McPcholkin/DIY_Soldering_Station/README.md

testing  and developing DIY soldering station
