McPcholkin/DIY_Soldering_Station/DIY_Soldering_Station-eagle/ProMini-connection.sch

## EAGLE design DIY_Soldering_Station-eagle/ProMini-connection.sch (2017-05-05)

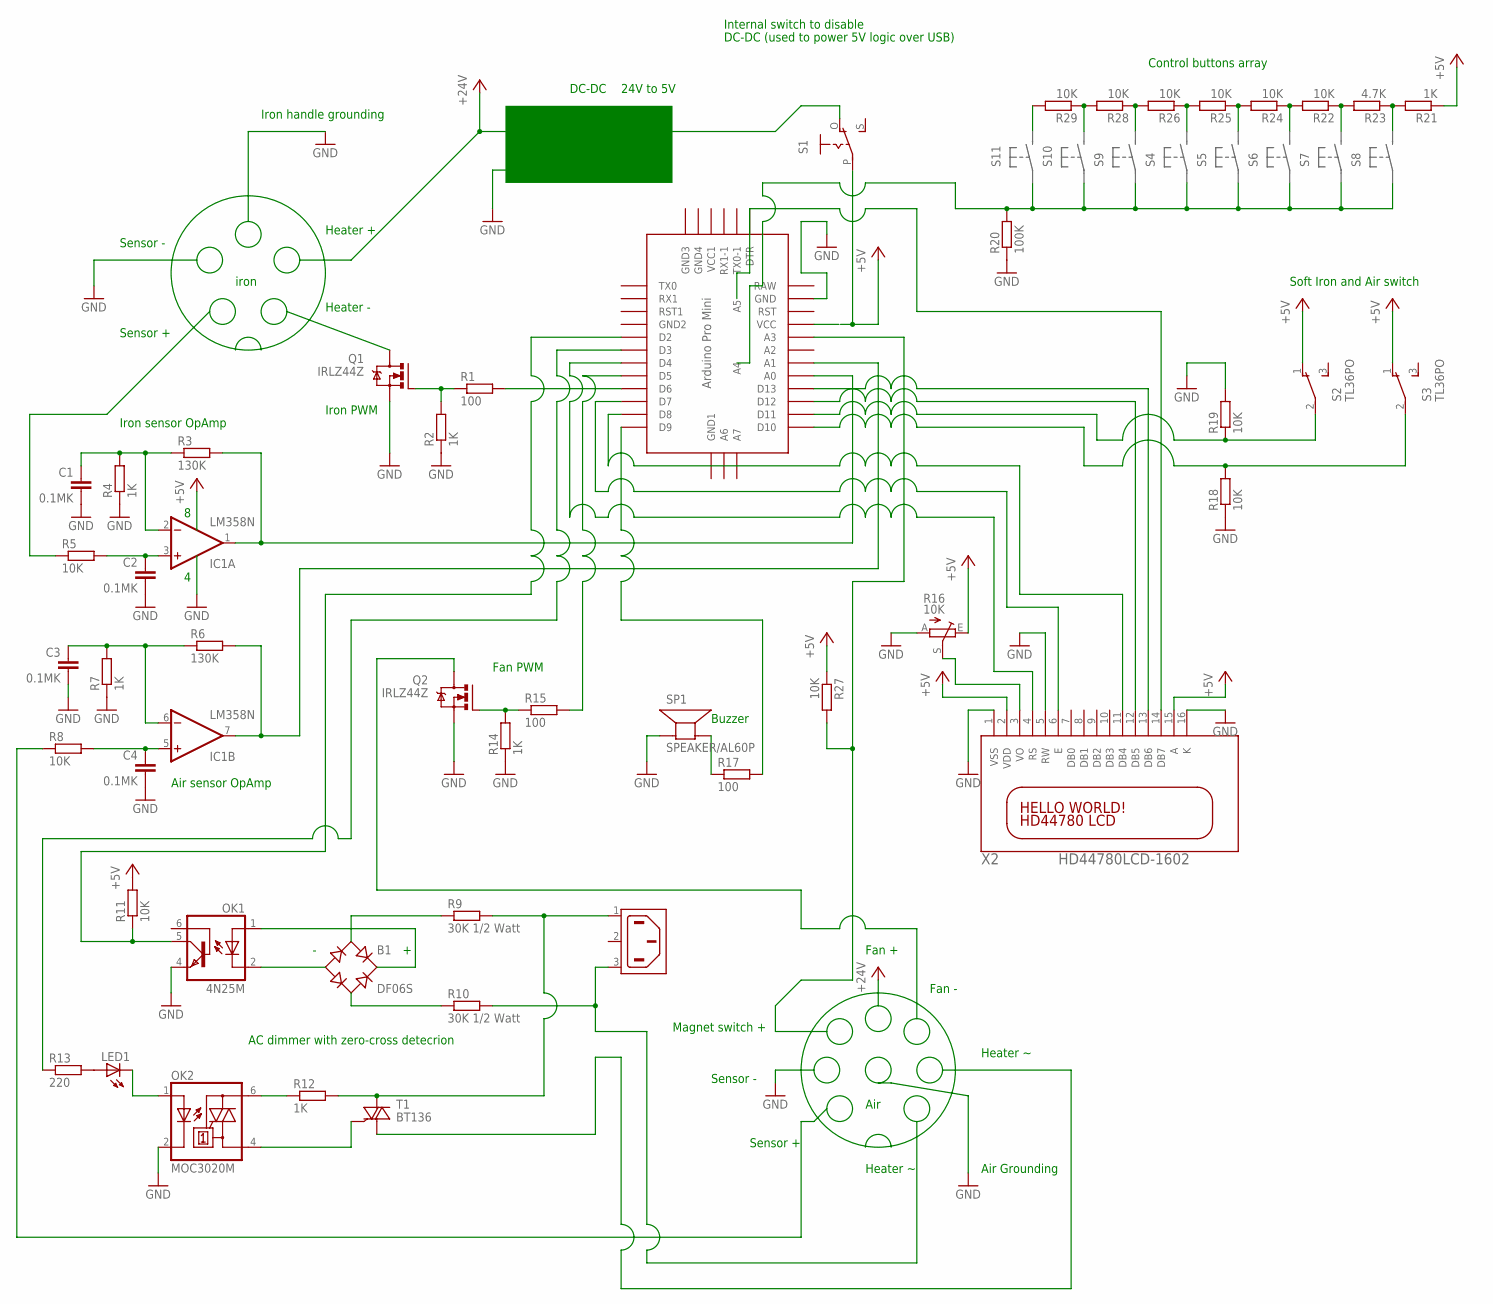
[picture p1: schematic ProMini-connection.sch]

Parts:
B1: DF06S; DFS
C1, C2, C3, C4: 0.1MK; C025-024X044
IC1: LM358N; DIL08
LED1: LED3MM
OK1: 4N25M; DIL06
OK2: MOC3020M; DIL06
Q1, Q2: IRLZ44Z; TO220BH
R1, R15, R17: 100; 0207/7
R2, R4, R7, R12, R14, R21: 1K; 0207/7
R3, R6: 130K; 0207/7
R5, R8, R11, R18, R19, R22, R24, R25, R26, R27, R28, R29: 10K; 0207/7
R9, R10: 30K 1/2 Watt; 0207/7
R13: 220; 0207/7
R16: 10K; B64Y
R20: 100K; 0207/7
R23: 4.7K; 0207/7
S1: EG1218S; EG1218
S2, S3: TL36PO; TL3XPO
SP1: SPEAKER/AL60P; AL60P
T1: BT136; TO220AB
U$1: ABK-PRO-MINI
X1: 6ESRM-P
X2: HD44780LCD-1602; LCD1602

Connections:
+5V: R11.2, R16.E, R21.1, R27.1, S2.1 (O), S3.1 (O), X2.2 (VDD), X2.15 (A)
GND: C1.2, C2.2, C3.2, C4.2, OK1.4 (EMI), OK2.2 (C), Q1.S, Q2.S, R2.1, R4.1, R7.1, R14.1, R16.A, R18.1, R19.2, R20.1, SP1.1 (+), U$1.GND, X2.1 (VSS), X2.5 (RW), X2.16 (K)
unnamed: Q1.G, R1.1, R2.2
unnamed: R1.2, U$1.D6
unnamed: IC1.1 (OUT), R3.2, U$1.A0
unnamed: IC1.7 (OUT), R6.2, U$1.A1
unnamed: C3.1, IC1.6 (-IN), R6.1, R7.2
unnamed: C4.1, IC1.5 (+IN), R8.2
unnamed: C1.1, IC1.2 (-IN), R3.1, R4.2
unnamed: C2.1, IC1.3 (+IN), R5.2
unnamed: B1.AC1, R9.1
unnamed: B1.AC2, R10.1
unnamed: B1.+, OK1.1 (A)
unnamed: LED1.A, R13.2
unnamed: OK1.5 (COL), R11.1
unnamed: R17.2, U$1.D9
unnamed: OK2.6 (A2), R12.1
unnamed: R9.2, R12.2, T1.2 (A2), X1.1 (AC1)
unnamed: OK2.4 (A1), T1.3 (G)
unnamed: LED1.K (C), OK2.1 (A)
unnamed: Q2.G, R14.2, R15.1
unnamed: U$1.D4, X2.4 (RS)
unnamed: R27.2, U$1.A3
unnamed: R17.1, SP1.2 (-)
unnamed: R13.1, U$1.D3
unnamed: R16.S, X2.3 (VO)
unnamed: U$1.D7, X2.6 (E)
unnamed: R28.2, R29.1
unnamed: U$1.D8, X2.11 (DB4)
unnamed: U$1.D12, X2.12 (DB5)
unnamed: U$1.D13, X2.13 (DB6)
unnamed: R18.2, R19.1, S2.2, S3.2, U$1.D11
unnamed: R21.2, R23.1
unnamed: R22.1, R23.2
unnamed: R22.2, R24.1
unnamed: R24.2, R25.1
unnamed: R25.2, R26.1
unnamed: R26.2, R28.1

Notes on the sheet:
Iron handle grounding
DC-DC
Air Grounding
Iron sensor OpAmp
Air sensor OpAmp
Buzzer
24V to 5V
Internal switch to disable
DC-DC (used to power 5V logic over USB)
Control buttons array
Soft Iron and Air switch
AC dimmer with zero-cross detecrion
iron
Heater +
Heater -
Sensor -
Sensor +
Magnet switch +
Fan +
Fan -
Heater ~
Fan PWM
Iron PWM
Air
