McPcholkin/DIY_Soldering_Station/FanCalibrate.txt

Fan cal

PWM  speed

5 stop
10 stop
20 stop 
30 start
35 minimal
65 set min!

80 min
100 good
135 normal
150 more than mid
200 hig
225 speed
240 max
