McPcholkin/DIY_Soldering_Station/(threads)

Thread 1 (2017-09-04):

Iron temp set to max when sensor fail

McPcholkin, 2017-09-04:
When sensor in iron fail (disconnected on screen) and power switch set to OFF temp on element rise to max and melt handle.

Need add set pwm to 0 when disconnected.

McPcholkin, 2017-09-21:
Fixed on 0e5f515051498881fd3b4a25e96fd2924bfec727

McPcholkin, 2017-09-21:
not fixed
