McPcholkin/DIY_Soldering_Station/(commit log)

2017-03-28 First attempt control iron via PWM
2017-03-28 Add buttons
2017-03-28 try set temp via buttons
2017-03-28 add debounce to buttons
2017-03-28 remove LED 7 segmetn code
2017-03-30 inc lcd refrash and disable buttons
2017-03-30 add iron power switch
2017-03-30 move iron calibration on top
2017-03-30 add iron calibration and state
2017-03-30 add fans speed map % to PWM value
2017-04-03 move pin 3 to pin 9, need use tone()
2017-04-03 replace all "int const" to "const int"
    [DIY_Soldering_Station.ino]
2017-04-03 add buzzer and PowerOn tone
    [DIY_Soldering_Station.ino]
2017-04-04 add eagle scheme
    [ProMini-connection.sch]
2017-04-04 add some titles to scheme
    [ProMini-connection.sch]
2017-04-05 add some res values and done connecting wires
    [ProMini-connection.sch]
2017-04-05 add debug sketch to test board
2017-04-06 replace some pins to save A3 pin
    [ProMini-connection.sch]
2017-04-06 add button support, air and fan control
2017-04-06 add iron calibration scetch
2017-04-06 Add Calibrate sketch for Air and Fan
2017-04-06 Add fan and iron calibration
2017-04-07 now air calibration is working using CyberLib.h
    [ProMini-connection.sch]
2017-04-07 add calibration table for air
2017-04-08 improve iron calibration and add some LCD features
2017-04-08 done fan controll
2017-04-08 fix negative values of air temp and disable debuging
    [DIY_Soldering_Station.ino]
2017-04-09 fix iron negative lalues on smoothing
    [DIY_Soldering_Station.ino]
2017-04-16 Try fix phantom cooldown
    [DIY_Soldering_Station.ino]
2017-05-04 add more buttons and reorder them
2017-05-04 fix cooldown when power-on with disconnecter air gun
    [DIY_Soldering_Station.ino]
2017-05-05 improve some schematic
    [ProMini-connection.sch]
2017-05-11 Fix cooling enable with disconnected Air, disable debug
    [DIY_Soldering_Station.ino]
2017-09-21 Try fix iron max temp when iron sensor fail
    [DIY_Soldering_Station.ino]
2017-09-21 Fixed iron max temp when iron sensor fail
    [DIY_Soldering_Station.ino]
2017-10-26 Winter is hete, fix air disconnected trashold
    [DIY_Soldering_Station.ino]
